Joel3407/hopper-fc/docs/ground_station_crop.png

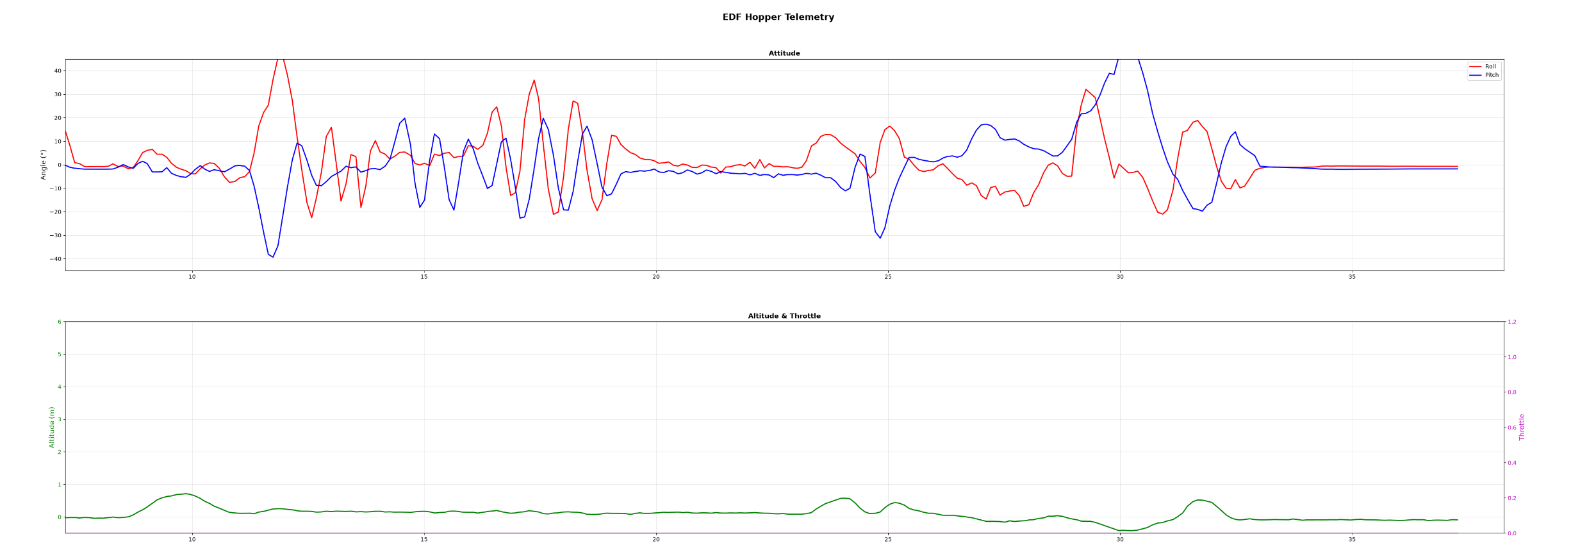
docs/ground_station_crop.png
