Joel3407/hopper-fc/(commit log)

2026-04-21 phase2: I2C scanner — all 3 sensors found on bus
2026-04-22 phase2: BMP580 pressure/temp/altitude working
2026-04-22 phase2: INA219 working - voltage/current/power reading
2026-04-22 phase2: MPU6050 (GY-521) working - temp IMU until BNO055 arrives
2026-04-22 phase2: all sensors combined - IMU/baro/GPS/power reading simultaneously
2026-10-06 tools: sensor monitor for BNO08X + BMP5xx + INA219 + GPS
2026-10-06 WIP: USB dual serial + 10 Hz telemetry frame (builds, not flashed)
2026-10-06 WIP: ground station with sync-scan parser and tests (not run on hardware)
2026-10-07 main.cpp: fix misleading messages/comments, renumber sections
    - BNO08X report-enable failure now says so instead of "not found"
    - status line: baro= is raw baro AGL, alt= is the Kalman altitude
    - add r (reset from ABORT) to the startup banner
    - renumber sections 1-13 in file order
    - checksum comment: state byte + five floats (21 bytes)
    - mark servo/ESC output, HOVER_BASE_US and ROLL/PITCH_SIGN as untested/unverified
    No control or estimation logic changed.
2026-10-07 ground station: remove dead command uplink, fix history size and header
    - docstring no longer promises command uplink; the firmware never reads
    SerialUSB1 and the uplink code was disabled and referenced an undefined `ser`
    - removed send_command(), command_interface() and the commented-out thread
    (so no command menu remains to update)
    - history buffer sized from TELEMETRY_HZ (10) x HISTORY_TIME (30 s) instead of
    3000 samples "at 100 Hz", so the buffer matches the 30 s plot window
    - dropped the "November 2025" date line
    test_parser.py: 6/6 pass.
2026-10-07 platformio.ini: drop lib_deps that src/ does not use
    Removed Adafruit BNO055, Adafruit BMP3XX, electroniccats/MPU6050 (only the
    archived .ino or the old IMU used them) and Adafruit Unified Sensor.
    Clean build (rm -rf .pio/build; pio run) succeeds without Unified Sensor, and
    the dependency graph does not link it, so it is not needed as an explicit
    dep. It is still present in .pio/libdeps as a transitive/leftover install.
2026-10-07 Archive old sketch; rewrite CLAUDE.md; add tools/README.md
    - move hopper_flight_controller.ino to archive/ with a README stating it targets
    older hardware (BNO055, BMP388, LoRa, SD) and is not built
    - CLAUDE.md now describes only the current code (BNO08X, BMP580, INA219, GPS
    read-but-unused, USB telemetry, SD commented out, LoRa not started, no
    airframe) and drops the long-term/personal notes
    - tools/README.md explains i2c_scanner and sensor_monitor and how to run them
2026-10-07 Add README.md
    Factual overview: hardware and pin table, architecture, build/flash/monitor and
    ground-station commands, and a status section split into verified on the bench,
    written but not verified, and not started. States that no airframe exists and
    nothing has flown. Notes the unidentified I2C device at 0x7E.
2026-10-07 README: describe unidentified I2C device at 0x7E as harmless, no effect seen
2026-10-13 Add case study and ground station screenshots
2026-10-14 Case study: reword decision 2 on separate USB ports
2026-11-04 ESC output on pin 6: safe idle, boot hold, single write path, bench ramp test
    - 1000 us idle written first in setup, before sensor init
    - 4 s boot hold before arming
    - all ESC writes go through esc_write_throttle
    - throttle forced to idle outside flight states
    - bench-only 'e' ramp (cap 1200 us, ESC_BENCH_TEST)
    - t/l disabled in bench builds
2026-11-07 Docs: record ESC bench result; low-voltage abort still unverified
2026-11-07 main.cpp: update comment on ESC bench-test status (comment only)
